open-flight/open-fp/hardware/cad/README.txt

open-fp - print files
Per plate: 4x 01_corner_cradle, 4x 02_cradle_retainer, 2x 07_edge_ramp_left, 2x 07_edge_ramp_right, 2x 07_edge_ramp_inner, 4x 10_hub_foot_tpu (TPU 95A)
Once: 1x 03_centre_enclosure_base, 1x 04_centre_enclosure_lid, 1x 09_drill_template (flip the plate for the other two corners)
Material: PETG or ABS (cradles carry load - no PLA). Cradles: 5 walls, 40% gyroid. Everything else: 3 walls, 20%. Hub feet: TPU 95A, 100% infill.
Orientation: cradles pocket-UP (plate face on bed; no supports/bridges - see hardware/bom.md), retainers flat, ramps on their flat bottom face, enclosure open-side up, lid vents-up, drill template lips-up.
Inserts: cradle M4 x2 (top), M2 x4 (bottom). Enclosure M2.5 in the 4 lid posts + Uno Q bosses + ADC grid as needed.
08_assembly_two_plates.step = full assembly for reference. forceplate_parts.py / extras_parts.py / assembly.py = CadQuery source.
08_assembly_two_plates.step predates the 2026-09-26 enclosure/ramp changes (see docs/VERIFIED.md).
