open-flight/open-fp/hardware/cad/renders/centre-enclosure-adc-fit.png

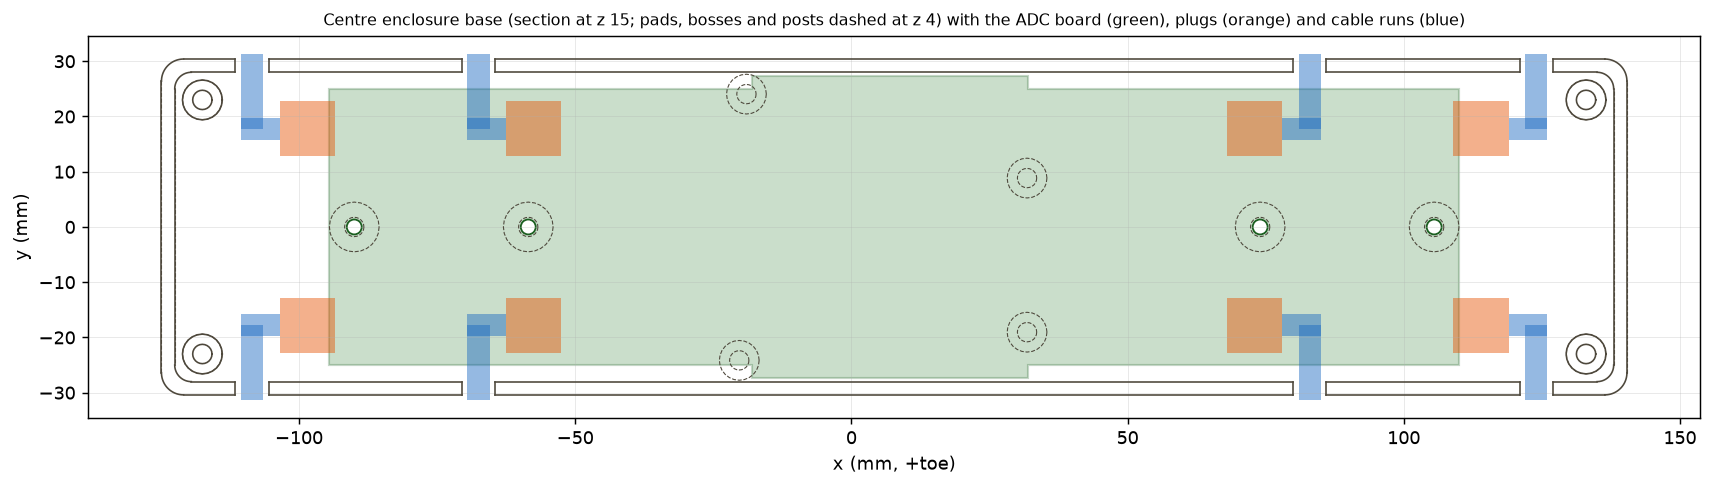
hardware/cad/renders/centre-enclosure-adc-fit.png
