open-flight/open-fp/hardware/pcb/adc-board/renders/adc-board-3d.png

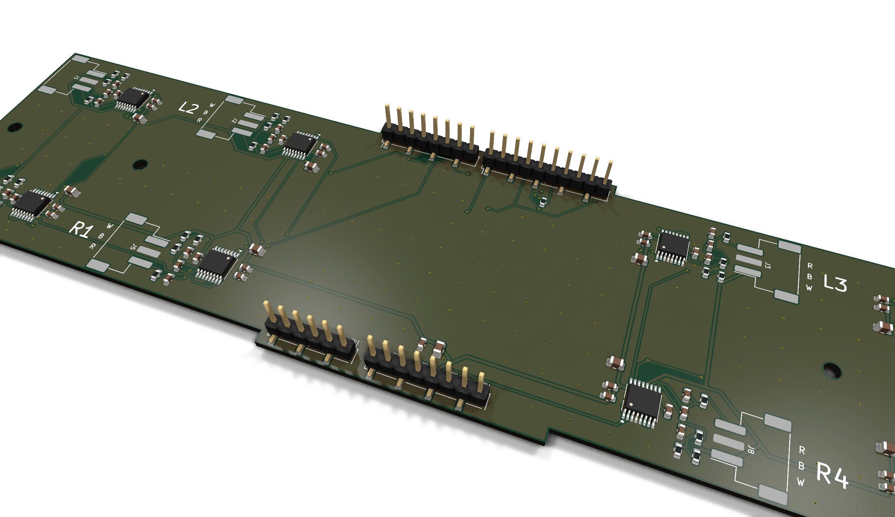
hardware/pcb/adc-board/renders/adc-board-3d.png
