open-flight/open-fp/hardware/pcb/adc-board/renders/adc-board-bottom.png

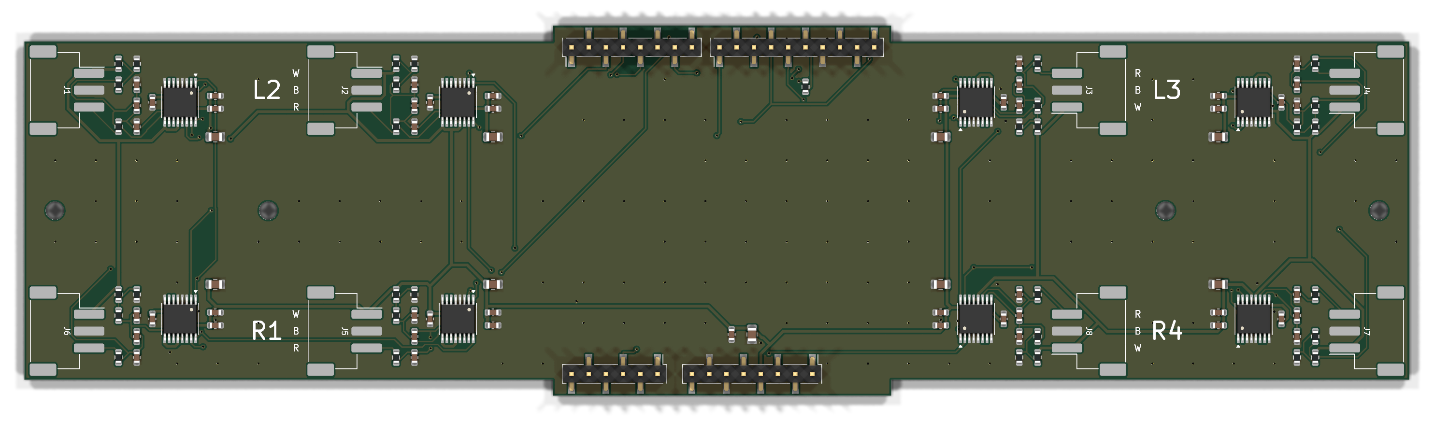
hardware/pcb/adc-board/renders/adc-board-bottom.png
