open-flight/open-fp/hardware/pcb/adc-board/renders/adc-board-top.png

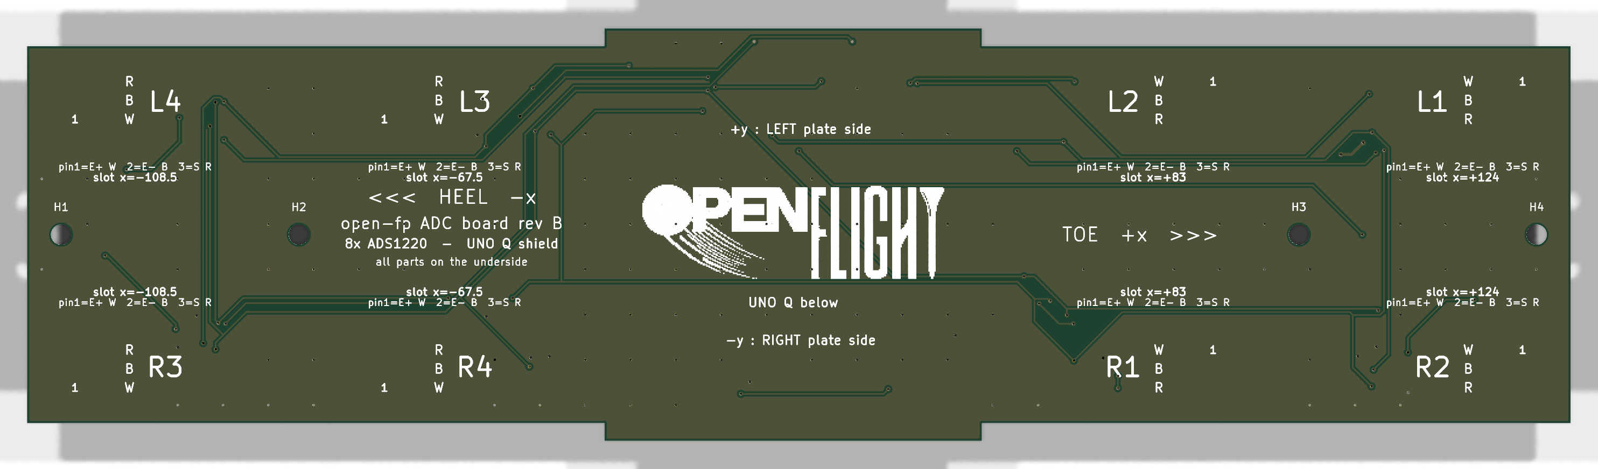
hardware/pcb/adc-board/renders/adc-board-top.png
