open-flight/open-fp/(list of files, cad)

Other CAD files:
hardware/cad/step/03_centre_enclosure_base.step
hardware/cad/stl/09_drill_template_b.stl
hardware/cad/step/04_centre_enclosure_lid.step
hardware/cad/stl/02_cradle_retainer.stl
hardware/cad/step/09_drill_template.step
hardware/cad/stl/09_drill_template_a.stl
hardware/cad/step/07_edge_ramp_inner.step
hardware/cad/step/07_edge_ramp_right.step
hardware/cad/step/11_cell_shim_tpu_1.5mm.step
hardware/cad/step/11_cell_shim_tpu_3.5mm.step
hardware/cad/step/11_cell_shim_tpu_3.0mm.step
hardware/cad/step/11_cell_shim_tpu_2.5mm.step
hardware/cad/step/10_hub_foot_tpu.step
hardware/cad/step/01_corner_cradle.step
hardware/cad/step/07_edge_ramp_left.step
hardware/cad/stl/01_corner_cradle.stl
hardware/cad/stl/03_centre_enclosure_base.stl
hardware/cad/stl/04_centre_enclosure_lid.stl
hardware/cad/stl/07_edge_ramp_left.stl
hardware/cad/stl/07_edge_ramp_right.stl
hardware/cad/stl/09_drill_template.stl
hardware/cad/stl/11_cell_shim_tpu_1.5mm.stl
hardware/cad/stl/11_cell_shim_tpu_2.5mm.stl
hardware/cad/stl/11_cell_shim_tpu_3.5mm.stl
