open-flight/open-fp/docs/VERIFIED.md

# VERIFIED

This file records the answer to every **VERIFY** item in [`PROJECT_INIT.md`](PROJECT_INIT.md). For each answer, give the tool, library, or datasheet version it was checked against and the date.

| # | Item | Answer | Checked against | Date |
|---|---|---|---|---|
| 1 | Arduino_RouterBridge: binary arg support in `notify()`, blocking behavior, max message size | | | |
| 2 | Router baud default (`arduino-router.service`); can it be raised on both sides? | **115200** on `/dev/ttyHS1`, set via `--serial-baudrate` in `/run/systemd/generator/arduino-router.service.d/10-imola.conf`. Whether it can be raised is still open. | `systemctl cat arduino-router` | 2026-09-23 |
| 3 | Zephyr core: `attachInterrupt` on D2, SPI on D11–D13 at 2 MHz, `micros()` resolution | D11/D12/D13 = PB15/PB14/PB13 = SPI2 MOSI/MISO/SCK (default `SPI`). D2 = PB3, `attachInterrupt` implemented (`WInterrupts.cpp`). **D10 = PB9 is in SPI2's pinctrl as hardware NSS**, so R4's CS moved to A2 (PA6, which only the ADC claims and has no pinctrl). Avoid A0 (DAC1 claims PA4), A1 (DAC out2), D0/D1 (USART1 console), A4/A5 (I2C3). D4/D5 are FDCAN1 pins, but CAN is deferred-init, so they work as GPIO unless CAN is started. **Hardware, 2026-09-25:** SPI at 2 MHz works (ADS1220 register readback OK), and `attachInterrupt` on D2 (FALLING) counts DRDY at ~950 Hz. About 9 edges are lost in each 100 ms window containing a Monitor RPC, so the router RPC appears to block interrupts briefly. Still open: `micros()` resolution. | arduino:zephyr 1.0.0 variant overlay and generated devicetree | 2026-09-23 |
| 4 | WebUI brick: Socket.IO event naming, `expose_api` path params + POST bodies, bind address, static asset path | Binds `0.0.0.0:7000`; assets from `/app/assets` (needs `index.html`). `expose_api(method, path, fn)` = FastAPI `add_api_route`, so path params and body models work the standard FastAPI way; `ui.app` is the FastAPI instance. `send_message(event, dict\|str, room=None)` → `sio.emit(event, …)`; browser uses `libs/arduino.js` `WebUI.on_message(event, cb)` on raw socket.io. Server started only when `WebUI()` is instantiated in `main.py`. | `python-apps-base:0.12.0`, `arduino/app_bricks/web_ui/web_ui.py` | 2026-09-23 |
| 5 | App container: persistent data path, `requirements.txt` support, numpy preinstalled? | numpy 2.5.1, fastapi 0.141.1, uvicorn 0.52.1, msgpack 1.2.1 preinstalled (CPython 3.13.14). App venv lives in `<app>/.cache/.venv`. Persistence and `requirements.txt` handling are still open. | `docker run python-apps-base:0.12.0` | 2026-09-23 |
| 6 | `arduino-app-cli`: start/stop/logs/autostart commands; App Lab app dir on the board | App dir `/home/arduino/ArduinoApps/open-fp`. `app start\|stop\|restart <path>`, `app logs <path> [--follow] [--tail N] [--all]`, `monitor` (MCU serial). Autostart candidate: `properties set default <path>` (boot behavior untested). **No `rsync` on board**: deploy uses tar. | `arduino-app-cli` 0.13.0 | 2026-09-23 |
| 7 | ADS1220 module: exposed pins (CLK, REFP0/REFN0, AVDD/DVDD), onboard regulator, hole spacing | Purple ADS1220 breakout. Left edge: DRDY, MISO, MOSI, SCLK, CS, CLK, DVDD, DGND. Right edge: AIN0–AIN3, REFN0, REFP0, AVDD, AGND. Supplies and grounds are split (DVDD/AVDD, DGND/AGND), so both pairs must be wired; CLK is broken out, so tie it to GND. **Still open:** onboard regulator, board size and hole spacing. | owner's photo of the board | 2026-09-25 |
| 8 | Load cell wire colors (per cell, see `wiring.md`) | **Red = centre tap (S); white and black = ends (E+/E−)** on L1. Wiring white as S put AIN0 at the 3.3 V rail; with red on AIN0 it reads 1663 mV. Check the other seven with a meter. | ADC self-check on L1 | 2026-09-25 |
| 9 | App Lab first-boot steps (§11.1) | Board name, Wi-Fi, `arduino` password, updates, exactly as in §11.1. Board reachable at `open-fp.local`. OS: Debian 13 (trixie), kernel 6.16.7, aarch64. | App Lab (owner), `uname -a` | 2026-09-23 |

## Bench measurements (M1/M2)

| Channel | Unloaded mean (counts) | Std dev (counts) | Register readback | Notes |
|---|---|---|---|---|
| L1 | 172,789 (differential) | 606 | OK (`81 C4 40 00`) | AIN0 1660 / AIN1 1660 mV; 13 % repeated reads (bench loop). Earlier: single-ended 4,204,513, std 116, thumb press −343 (2026-09-25). toe carrier on stripboard, differential gain 128 with 1.5 kΩ R1/R2; press test pending. 2026-10-12 |
| L2 | 1,405,031 (differential) | 1,076 | OK (`81 C4 40 00`) | AIN0 1659 / AIN1 1655 mV. toe carrier on stripboard, differential gain 128 with 1.5 kΩ R1/R2; press test pending. 2026-10-12 |
| L3 | | | | |
| L4 | | | | |
| R1 | −2,509,256 (differential) | 2,018 | OK (`81 C4 40 00`) | AIN0 1661 / AIN1 1669 mV: the R1/R2 pair is about 8 mV off centre, so about 30 % of the range goes to offset. toe carrier on stripboard, differential gain 128 with 1.5 kΩ R1/R2; press test pending. 2026-10-12 |
| R2 | 198,719 (differential) | 814 | OK (`81 C4 40 00`) | AIN0 1660 / AIN1 1660 mV. toe carrier on stripboard, differential gain 128 with 1.5 kΩ R1/R2; press test pending. 2026-10-12 |
| R3 | | | | |
| R4 | | | | |

Achieved loop rate: L1 DRDY 944 Hz; the bench sketch reads about 71 % of conversions with four channels (Monitor output blocks it) · `drdyMissed` over 10 min: —

## Toolchain

| Item | Answer | Checked against | Date |
|---|---|---|---|
| FQBN for `arduino-cli` | `arduino:zephyr:unoq` (core `arduino:zephyr`, "Arduino Q Boards") | arduino-cli 1.5.1, arduino:zephyr 1.0.0, `arduino-cli board list` | 2026-09-23 |
| Board ports | USB serial `/dev/cu.usbmodem*` and network port (mDNS `open-fp.local`), both detected as Arduino UNO Q | `arduino-cli board list` | 2026-09-23 |
| Compiling on this Mac | Arduino's builtin `ctags` 5.8-arduino11 is x86-only and fails (`bad CPU type`) without Rosetta. `tools/bench/flash.sh` swaps in a no-op stand-in when it can't run; ctags only generates function prototypes, and the bench sketches define every function before use. `bench/ads1220_all` compiles: 95 KB flash, 42 KB RAM | arduino-cli, arduino:zephyr 1.0.0, macOS (Darwin 27) on Apple Silicon | 2026-09-29 |

## Bench tooling

| Item | Answer | Checked against | Date |
|---|---|---|---|
| `Monitor` for bench sketches | `Arduino_RouterBridge` 0.4.3 `Monitor` (a `Stream`) sends output to the Linux side as `mon/write` RPCs; read it with `arduino-app-cli monitor` | library source `src/monitor.h` | 2026-09-24 |
| `bench/ads1220_single` builds | compiles for `arduino:zephyr:unoq` (89 KB flash, 36 KB RAM) | arduino-cli 1.5.1, arduino:zephyr 1.0.0, Arduino_RouterBridge 0.4.3 | 2026-09-24 |
| USB upload + monitor | **Works end to end.** `tools/bench/flash.sh` uploads over USB: arduino-cli → adb → OpenOCD on the Linux side, which flashes the STM32U585 (2 MB, dual-bank, RDP 0). `ssh arduino@open-fp.local arduino-app-cli monitor` streams the sketch's `Monitor` output, including without a TTY (what `single_cell.py` uses), and keystrokes sent to it reach the sketch (`r` re-runs the readback). With no ADC wired: `R,0,00,00,00,00` (D12 floats low), then `E,no DRDY` every 500 ms. | arduino-cli 1.5.1, UNO Q over USB | 2026-09-24 |

## Bench findings

| Item | Result | Checked against | Date |
|---|---|---|---|
| Monitor RPC cost | Each `Monitor.available()`/`println` call blocks the MCU loop for roughly 13 ms (a loop polling DRDY captured ~150 of 1000 samples/s when checking `Monitor.available()` every loop). **The firmware must not call the router in the sampling loop;** batch sends as the spec plans (`Bridge.notify` at 20 Hz) and check whether they block the same way. | bench/ads1220_single on hardware | 2026-09-25 |
| ADC self-test ('v') on L1, wired except R1/R2 | AVDD 3333 mV, external REF 3316 mV (REFP0/REFN0 OK), AIN1 552 mV (floating, no R1/R2 yet), **AIN0 > 2048 mV: at the 3.3 V rail, not the ~1650 mV centre-tap voltage.** Cause: white was wired as S, but red is the centre tap. **After swapping (red → AIN0):** AVDD 3333, REF 3317, **AIN0 1663 mV**. Single-ended reading ≈ 4,204,500 counts (= 1663/3317 of full scale), per-sample noise 127 counts at gain 1, 100 ms means within ~60 counts, DRDY 94–95 per 100 ms. | bench/ads1220_single voltage check | 2026-09-25 |

- **2026-09-25, L1 live view (single-ended, gain 1):** 100 ms averages steady within tens of counts, rate ~940 Hz. **Occasional single-sample outliers of −1,000 to −2,000 counts (one +800),** about 0.4–0.8 mV, visible only in the per-window min/max. Unconfirmed guess: a late read when a Monitor RPC delays the loop, racing the next conversion. Recheck in differential mode with R1/R2, and in the real firmware, which reads each sample paced by DRDY.

| Enclosure interior, measured from `03_centre_enclosure_base.step` | Outer 294.8 × 60.8 × 19.9 mm. Cavity about **55.8 mm wide**, 292 mm long, floor at z 2.6. **ADC pads** at each end: x ±47 to ±137 mm from centre, y ±25 (about **90 × 50 mm**), top at z 5.4, with a 7.5 mm grid of insert holes. **14.5 mm clearance** from the pad top to the rim. Lid posts at x = ±140, y ±23 (the x = 0 pair was removed 2026-09-26, see Mechanical fixes); UNO Q bosses near x ≈ 30. The ADS1220 breakout measures about 21 × 21 mm, with header columns 7 holes (17.8 mm) apart. **Carrier: 37 × 17-hole stripboard (~94 × 43 mm) with 4 breakouts in a row**, placed about x = 40–134 mm, clear of the UNO Q (|x| ≤ 34.3) and the lid posts (x ±140). Breakouts are soldered directly, with no sockets (sockets add ~8.5 mm). An earlier 2 × 2 idea was dropped: the paired pin rows make a single row fit. | CadQuery 2.8 probes of the STEP | 2026-09-25 |

- **2026-09-25, second breakout (bench, single-ended):** readback OK and voltages correct (AIN0 1655 mV), but **conversions are bit-identical** (raw dump: 32 × `3FFD8A`), with occasional jumps of exactly ±257 (0x101). The first breakout showed ~110 counts of noise in the same mode. Suspects: another board sharing the bus with its CS not held high, or a faulty or non-genuine chip. Swap test pending.

- **2026-10-16, carrier split is one per plate.** The first carrier holds all four corners of one plate, not the toe corners of both plates as `docs/harness.md` first described. The L1/L2/R1/R2 names in the table above are the CS slots each unit was on at the time (D3, D4, D7, D8), not its corner. Before the plates are used, re-wire the CS lines by corner (plate L carrier on D3–D6, plate R on D7, D8, D9, A2) and confirm each with a press test. Docs and diagrams updated to match.

## Performance

| Item | Result | Checked against | Date |
|---|---|---|---|
| Pipeline and SwingDetector CPU cost on the board | 41.9 s of synthetic 200 Hz data (5 swings, all captured) processed in 6.35 s, about 15 % of one core | `python-apps-base:0.12.0` on the UNO Q (Python 3.13.14, numpy 2.5.1) | 2026-09-23 |

## Mechanical fixes

- **2026-09-23, cable notch didn't break through.** The test print showed a wall in the cradle's cable notch. Measured from the STL: the notch spanned y −28…−18 and the pocket wall is at y −17.3, leaving a 0.7 mm wall through the notch's full 7.2 mm depth. The retainer's notch (y −28…−18) also stopped 4 mm short of its window (y −14), so it would clamp the wires against the cell. The owner confirmed the wall shouldn't be there. Fixed by loading the STEP files in CadQuery 2.8 and cutting 7 mm wide slots to join each notch to the pocket or window. Removed 35.3 mm³ (cradle) and 44.8 mm³ (retainer), both still single valid solids. STL and STEP re-exported.

- **2026-09-23, locating hub foot.** The owner asked for a foot that locates on the cell. The cell's load point is a riveted strap across the centre tongue with a dome in the middle, and it faces the floor. The new `10_hub_foot_tpu` (from `hardware/cad/src/hub_foot.py`) is Ø18 × 4.7 mm with an 11.4 × 1.2 mm channel for the strap and a Ø6 × 0.6 mm dimple for the dome. It keeps 3.5 mm of foot below the load point, so floor clearance is unchanged. The strap width (11.0) and dome diameter (5.5) were estimated from photos. **The test print fits well (owner, 2026-09-23)**, so the estimated dimensions stand.

- **2026-09-23, cell rattles vertically under the retainer.** The raised centre strap faces out, so the frame's outer edge sits a few mm below the rim and the flat retainer doesn't touch it. Added a TPU shim ring (`11_cell_shim_tpu`, from `hardware/cad/src/cell_shim.py`): 34 mm outside, 28.6 mm inside, so it rests only on the frame and stays clear of the tongue and strap, with a 9 mm gap at the cable notch. It comes as a tuning set of 1.5–3.5 mm; The fit test found the tightest stack was **3.5 mm under the cell plus 1.5 mm over it**, so the frame is about 3.2 mm thick. The 3.5 mm moved into the cradle as a rigid PETG ledge, keeping TPU out of the load path, and **the 1.5 mm TPU shim goes on top**.

- **2026-09-23, relief too small for the cell's tongue.** The Ø24 relief didn't clear the tongue, which is about 21 × 19 mm with a ~28 mm diagonal (estimated from a photo, frame = 34 mm). Anything touching the tongue carries load around the strain gauges and the reading comes out low. Replaced it with a 28 × 28 mm rounded-square relief (r 3), same 1.5 mm depth: 485.8 mm³ removed, still a single valid solid. The frame now bears on a 3 mm band all round, directly opposite the shim ring and retainer lip. **Confirmed by the owner:** the tongue does reach the old Ø24 cradle, so that print is retired and all 8 cradles are being printed from the new file.

- **2026-09-23, cradle bearing ledge.** Added a 3.5 mm PETG ledge to the pocket, between the 28 mm relief and the 34.6 mm pocket wall, so the frame bears at 4.7 mm from the open face: 1457 mm³ added, still a single valid solid, and the notch was re-cut clear. The tongue now has 5 mm of clearance to the relief ceiling. **Measured 2026-09-26 (owner):** a finished corner stands about 3/4" (19 mm) from floor to the cradle's plate face, so the aluminium top is at about 25.4 mm and the neoprene at about 27 mm. The ramps were raised to match (below).

- **2026-09-26, pre-print check of the remaining parts.** Checked in CadQuery 2.8 against the printed cradle stack. The drill template matches the cradle's M4 inserts (±22.5 mm) and centre, so it prints unchanged. (2026-09-28: template B, the mirror of A, was dropped and A renamed `09_drill_template`; flipping the plate covers the other two corners.) Changed:
  - **Enclosure base: centre lid posts removed.** The Q's bosses put its board at x −34.3…34.3, y −26.6…26.7 (UNO hole pattern), and the full-height posts at x = 0, y ±23 (Ø7.2) stood inside it, under the header rows. Removed 1329 mm³. The lid is now held by the four end posts; **install 4 lid inserts, not 6.**
  - **Enclosure base: cable slots added to the −y wall.** All four 6 × 6.7 mm slots (x ±85, ±125) were in the +y wall, which faces Plate L, so Plate R's cells had no way in. Mirrored them onto the −y wall (403 mm³ removed).
  - **Enclosure base: UNO Q bosses raised 3 → 5 mm** (top at z 7.4, owner's call for underside clearance), with the M2.5 insert holes now 5 mm deep to match the spec. 249 mm³ added. The Q's board top is now at z 9.0, so 8.5 mm female headers reach z 17.5, leaving **about 2.4 mm to the lid** (z 19.9) for wires entering the headers.
  - **Lid:** filled the two centre countersunk holes and their lip notches (61 mm³ added).
  - **Ramps: rise 20 → 24.5 mm,** about 1 mm below the aluminium top at the measured 25.4 mm, keeping the 60 mm run (slope 22°).
  - **Ramps: new `07_edge_ramp_inner`.** Every piece had a 45° mitre at one end, so on each plate's front and back sides the mitre pointed into the gap at the enclosure end, and the two plates' pieces overlapped by about 59 mm. The inner piece has square ends and stops 5 mm short of the gap centre, leaving a 10 mm channel. Now 4 left + 4 right + 4 inner (was 6 + 6).
  - All still single valid solids; STLs watertight. `08_assembly_two_plates.step` was not regenerated.
  - **Still open:** the USB-C slot is in the heel end wall, about 110 mm from the Q's USB-C port (board edge at x −34.3), so the cable has to run inside past the heel carrier.

- **2026-10-12, enclosure raised for the assembled ADC board** (`hardware/pcb/adc-board`, which sits on the Q's headers with its top at z 21.6). Edited in CadQuery 2.8 from the committed STEP files; both are still single valid solids.
  - **Base: walls and lid posts raised 2.4 mm** (wall top z 19.9 → 22.3, outer height 21.9 → 24.3 with the lid, still below the 24.5 mm ramps). Done by splitting at z 17 and inserting a 2.4 mm copy of the wall section, so the lid-post insert holes stay at the top (now 7.9 mm deep). 4325 mm³ added.
  - **Base: the eight cable slots now run z 2.4 → 19.0** (were 2.4 → 9.4), same 6 mm width at x ±85, ±125 in both long walls, so a cable leaves its JST plug (just under the board) straight through the wall. 1106 mm³ removed.
  - **Lid: locating lip removed on both long sides for x −34 … +34** (y 24.5 … 29), clearing the board's header tabs (y ±27.35 at x −18 … +32). Cut symmetric in x so the lid can go on either way round. 490 mm³ removed.
  - The stripboard carriers fit the taller enclosure unchanged. `08_assembly_two_plates.step` was not regenerated.

- **2026-11-11, enclosure rev B for the 204.5 mm ADC board** (`hardware/pcb/adc-board` rev B). The enclosure is now generated from source, `hardware/cad/src/centre_enclosure.py`, instead of edited in the STEP. Its `REV_A` parameters reproduce the committed rev A base and lid exactly (CadQuery 2.8 boolean difference against commit 064a41c: 0.00 mm³ both ways, both parts), so every rev A detail carries over, including the −y slots' 2.4 mm nick into the old pads. `REV_B` changes (details in the board README, "Rev B enclosure changes"):
  - **Cable slots** at x −108.5, −67.5, +83, +124 in both long walls (6 mm, z 2.4 – 19.0).
  - **ADC pads:** the two 90 × 50 mm pads and their 7.5 mm insert grid are replaced by four Ø9 pads (top z 5.4) with one Ø3.5 × 2.5 mm M2.5 insert hole each, at (−90, 0), (−58.5, 0), (+74, 0), (+105.5, 0).
  - **Lid posts** at x −117.5 / +133, y ±23 (2 mm past the outer slots), **cavity x −122.5 … +138**: outside 265.3 × 60.8 × 24.3 mm with the lid (was 294.8 long), x −124.9 … +140.4, so the box is no longer centred on x = 0. Shorter only makes the gap between the plates' ends and the box wider.
  - Lid: posts, countersunk holes and lip follow; vents keep the 12 mm grid (x −96 … +108).
  - Base 71 315 mm³ (was 100 908), lid 31 656 mm³ (was 35 096); both single valid solids.
  - **Fit check** (`hardware/cad/src/check_adc_fit.py`, reads `adc-board.kicad_pcb`): all four board holes on pad inserts (to 0.01 mm), and 0.00 mm³ overlap between the base or the fitted lid and the board, the underside-part zone, the UNO Q stack, the standoffs, the eight plugs and the cable runs to the slots. The same check on rev A fails (holes off the grid, six of eight cable runs into the wall). Plug size (10 × 10 mm) and the cable route are still estimates (**VERIFY** with a real plug). Not printed yet.
  - The stripboard carriers need rev A (`centre_enclosure.py --rev a`). `08_assembly_two_plates.step` was not regenerated.

## Notes found during scaffolding

- App Lab's generated skeleton puts the web client libs in `app/assets/libs/` (`arduino.js`, `socket.io.min.js`), not `assets/vendor/` as §2 planned. Keep `libs/` from the brick and put uPlot in `vendor/`.

- **CAD sources are not runnable as committed.** The scripts in `hardware/cad/src/` write to hard-coded output paths (`/home/claude`, `/home/claude/extras`). `assembly.py` also imports `cairosvg`. `forceplate_parts.py` exports `03_enclosure_base` and `04_enclosure_lid`, but the committed files are named `03_centre_enclosure_base` and `04_centre_enclosure_lid`. The sources are unchanged for now; ask the owner before editing them. (2026-11-11: the enclosure now has its own source, `centre_enclosure.py`, which writes to `hardware/cad` and supersedes the enclosure section of `forceplate_parts.py`.)
- **The CAD sources are an older revision than the STL/STEP files.** `forceplate_parts.py` has a cradle height of 14 mm (STL: 11.2), a relief depth of 2 mm (STL: 1.5), and a 2 mm retainer (STL: 1.6). Its enclosure is 150 × 70 mm, while the spec says 295 × 61 × 22. The STL/STEP files match the spec and are what gets printed. Update the sources before regenerating any part. Measured 2026-09-23 from the STL: the cradle is 54 × 54 × 11.2 with the pocket open at z=0, the pocket ceiling at 8.2, the relief ceiling at 9.7, the notch ceiling at 7.2, M2 holes 4 deep, and M4 holes 6.5 deep from the top.
