open-flight/open-fp/hardware/pcb/adc-board/adc-board.kicad_pcb

## KiCad design hardware/pcb/adc-board/adc-board.kicad_pcb (2026-11-11)

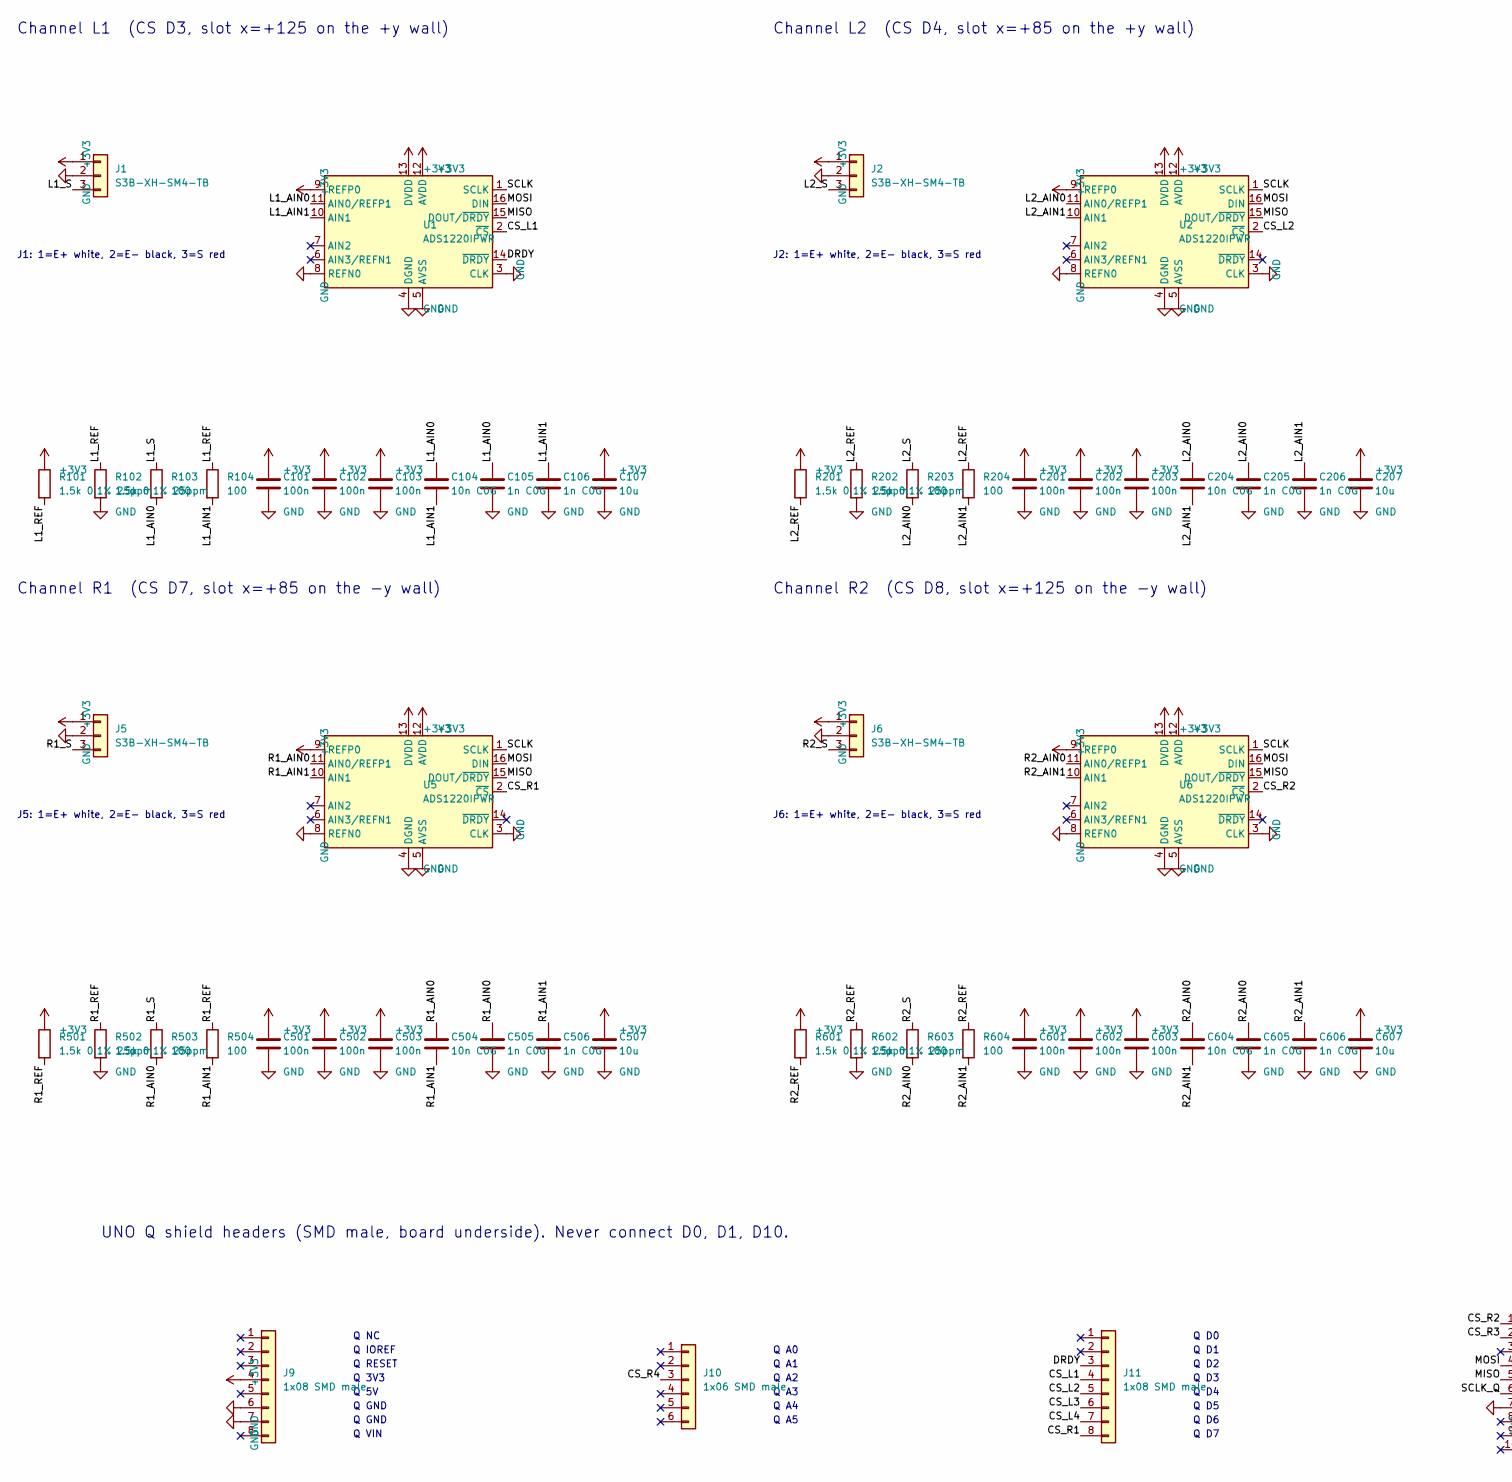
[picture p5: schematic adc-board.kicad_sch, open-fp ADC board (8x ADS1220, UNO Q shield), part in row 1, column 1]

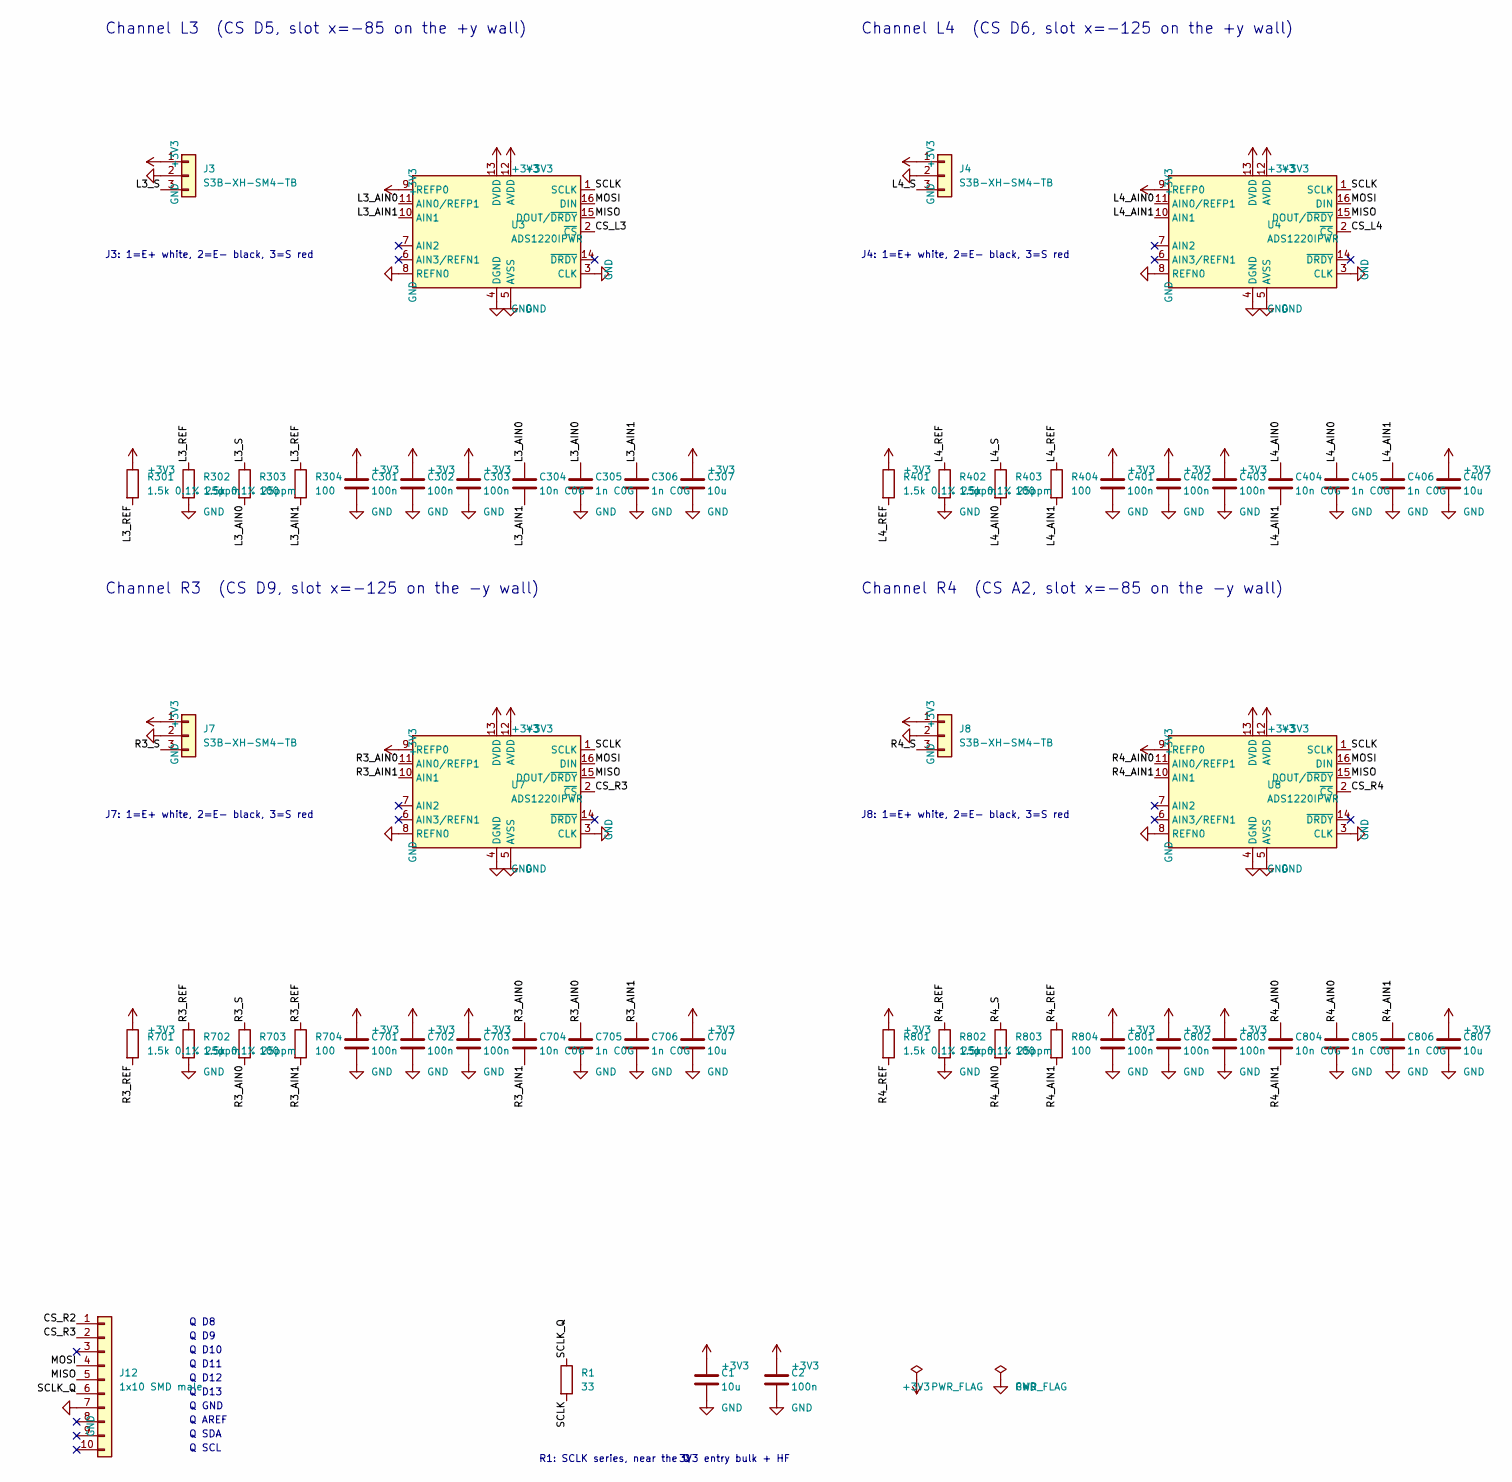
[picture p6: schematic adc-board.kicad_sch, open-fp ADC board (8x ADS1220, UNO Q shield), part in row 1, column 2]

Parts:
C1, C107, C207, C307, C407, C507, C607, C707, C807: 10u; C_0805_2012Metric; MPN GRM21BR61C106KE15L
C2, C101, C102, C103, C201, C202, C203, C301, C302, C303, C401, C402, C403, C501, C502, C503, C601, C602, C603, C701, C702, C703, C801, C802, C803: 100n; C_0603_1608Metric; MPN GRM188R71H104KA93D
C104, C204, C304, C404, C504, C604, C704, C804: 10n C0G; C_0603_1608Metric; MPN GRM1885C1H103JA01D
C105, C106, C205, C206, C305, C306, C405, C406, C505, C506, C605, C606, C705, C706, C805, C806: 1n C0G; C_0603_1608Metric; MPN GRM1885C1H102JA01D
J1, J2, J3, J4, J5, J6, J7, J8: S3B-XH-SM4-TB; JST_XH_S3B-XH-SM4-TB_1x03-1MP_P2.50mm_Horizontal; MPN S3B-XH-SM4-TB(LF)(SN)
J9, J11: 1x08 SMD male; PinHeader_1x08_P2.54mm_Vertical_SMD_Pin1Left; MPN TSM-108-01-T-SV-P
J10: 1x06 SMD male; PinHeader_1x06_P2.54mm_Vertical_SMD_Pin1Left; MPN TSM-106-01-T-SV-P
J12: 1x10 SMD male; PinHeader_1x10_P2.54mm_Vertical_SMD_Pin1Left; MPN TSM-110-01-T-SV-P
R1: 33; R_0603_1608Metric; MPN RC0603FR-0733RL
R101, R102, R201, R202, R301, R302, R401, R402, R501, R502, R601, R602, R701, R702, R801, R802: 1.5k 0.1% 25ppm; R_0603_1608Metric; MPN RG1608P-152-B-T5
R103, R104, R203, R204, R303, R304, R403, R404, R503, R504, R603, R604, R703, R704, R803, R804: 100; R_0603_1608Metric; MPN RC0603FR-07100RL
U1, U2, U3, U4, U5, U6, U7, U8: ADS1220IPWR; TSSOP-16_4.4x5mm_P0.65mm; MPN ADS1220IPWR

Connections:
+3V3: C1.1, C2.1, C101.1, C102.1, C103.1, C107.1, C201.1, C202.1, C203.1, C207.1, C301.1, C302.1, C303.1, C307.1, C401.1, C402.1, C403.1, C407.1, C501.1, C502.1, C503.1, C507.1, C601.1, C602.1, C603.1, C607.1, C701.1, C702.1, C703.1, C707.1, C801.1, C802.1, C803.1, C807.1, J1.1, J2.1, J3.1, J4.1, J5.1, J6.1, J7.1, J8.1, J9.4, R101.1, R201.1, R301.1, R401.1, R501.1, R601.1, R701.1, R801.1, U1.9 (REFP0), U1.12 (AVDD), U1.13 (DVDD), U2.9 (REFP0), U2.12 (AVDD), U2.13 (DVDD), U3.9 (REFP0), U3.12 (AVDD), U3.13 (DVDD), U4.9 (REFP0), U4.12 (AVDD), U4.13 (DVDD), U5.9 (REFP0), U5.12 (AVDD), U5.13 (DVDD), U6.9 (REFP0), U6.12 (AVDD), U6.13 (DVDD), U7.9 (REFP0), U7.12 (AVDD), U7.13 (DVDD), U8.9 (REFP0), U8.12 (AVDD), U8.13 (DVDD)
/CS_L1: J11.4, U1.2 (~CS)
/CS_L2: J11.5, U2.2 (~CS)
/CS_L3: J11.6, U3.2 (~CS)
/CS_L4: J11.7, U4.2 (~CS)
/CS_R1: J11.8, U5.2 (~CS)
/CS_R2: J12.1, U6.2 (~CS)
/CS_R3: J12.2, U7.2 (~CS)
/CS_R4: J10.3, U8.2 (~CS)
/DRDY: J11.3, U1.14 (~DRDY)
/L1_AIN0: C104.1, C105.1, R103.2, U1.11 (AIN0/REFP1)
/L1_AIN1: C104.2, C106.1, R104.2, U1.10 (AIN1)
/L1_REF: R101.2, R102.1, R104.1
/L1_S: J1.3, R103.1
/L2_AIN0: C204.1, C205.1, R203.2, U2.11 (AIN0/REFP1)
/L2_AIN1: C204.2, C206.1, R204.2, U2.10 (AIN1)
/L2_REF: R201.2, R202.1, R204.1
/L2_S: J2.3, R203.1
/L3_AIN0: C304.1, C305.1, R303.2, U3.11 (AIN0/REFP1)
/L3_AIN1: C304.2, C306.1, R304.2, U3.10 (AIN1)
/L3_REF: R301.2, R302.1, R304.1
/L3_S: J3.3, R303.1
/L4_AIN0: C404.1, C405.1, R403.2, U4.11 (AIN0/REFP1)
/L4_AIN1: C404.2, C406.1, R404.2, U4.10 (AIN1)
/L4_REF: R401.2, R402.1, R404.1
/L4_S: J4.3, R403.1
/MISO: J12.5, U1.15 (DOUT/~DRDY), U2.15 (DOUT/~DRDY), U3.15 (DOUT/~DRDY), U4.15 (DOUT/~DRDY), U5.15 (DOUT/~DRDY), U6.15 (DOUT/~DRDY), U7.15 (DOUT/~DRDY), U8.15 (DOUT/~DRDY)
/MOSI: J12.4, U1.16 (DIN), U2.16 (DIN), U3.16 (DIN), U4.16 (DIN), U5.16 (DIN), U6.16 (DIN), U7.16 (DIN), U8.16 (DIN)
/R1_AIN0: C504.1, C505.1, R503.2, U5.11 (AIN0/REFP1)
/R1_AIN1: C504.2, C506.1, R504.2, U5.10 (AIN1)
/R1_REF: R501.2, R502.1, R504.1
/R1_S: J5.3, R503.1
/R2_AIN0: C604.1, C605.1, R603.2, U6.11 (AIN0/REFP1)
/R2_AIN1: C604.2, C606.1, R604.2, U6.10 (AIN1)
/R2_REF: R601.2, R602.1, R604.1
/R2_S: J6.3, R603.1
/R3_AIN0: C704.1, C705.1, R703.2, U7.11 (AIN0/REFP1)
/R3_AIN1: C704.2, C706.1, R704.2, U7.10 (AIN1)
/R3_REF: R701.2, R702.1, R704.1
/R3_S: J7.3, R703.1
/R4_AIN0: C804.1, C805.1, R803.2, U8.11 (AIN0/REFP1)
/R4_AIN1: C804.2, C806.1, R804.2, U8.10 (AIN1)
/R4_REF: R801.2, R802.1, R804.1
/R4_S: J8.3, R803.1
/SCLK: R1.2, U1.1 (SCLK), U2.1 (SCLK), U3.1 (SCLK), U4.1 (SCLK), U5.1 (SCLK), U6.1 (SCLK), U7.1 (SCLK), U8.1 (SCLK)
/SCLK_Q: J12.6, R1.1
GND: C1.2, C2.2, C101.2, C102.2, C103.2, C105.2, C106.2, C107.2, C201.2, C202.2, C203.2, C205.2, C206.2, C207.2, C301.2, C302.2, C303.2, C305.2, C306.2, C307.2, C401.2, C402.2, C403.2, C405.2, C406.2, C407.2, C501.2, C502.2, C503.2, C505.2, C506.2, C507.2, C601.2, C602.2, C603.2, C605.2, C606.2, C607.2, C701.2, C702.2, C703.2, C705.2, C706.2, C707.2, C801.2, C802.2, C803.2, C805.2, C806.2, C807.2, J1.2, J2.2, J3.2, J4.2, J5.2, J6.2, J7.2, J8.2, J9.6, J9.7, J12.7, R102.2, R202.2, R302.2, R402.2, R502.2, R602.2, R702.2, R802.2, U1.3 (CLK), U1.4 (DGND), U1.5 (AVSS), U1.8 (REFN0), U2.3 (CLK), U2.4 (DGND), U2.5 (AVSS), U2.8 (REFN0), U3.3 (CLK), U3.4 (DGND), U3.5 (AVSS), U3.8 (REFN0), U4.3 (CLK), U4.4 (DGND), U4.5 (AVSS), U4.8 (REFN0), U5.3 (CLK), U5.4 (DGND), U5.5 (AVSS), U5.8 (REFN0), U6.3 (CLK), U6.4 (DGND), U6.5 (AVSS), U6.8 (REFN0), U7.3 (CLK), U7.4 (DGND), U7.5 (AVSS), U7.8 (REFN0), U8.3 (CLK), U8.4 (DGND), U8.5 (AVSS), U8.8 (REFN0)

Notes on the sheet:
Channel L1 (CS D3, slot x=+125 on the +y wall)
J1: 1=E+ white, 2=E- black, 3=S red
Channel L2 (CS D4, slot x=+85 on the +y wall)
J2: 1=E+ white, 2=E- black, 3=S red
Channel L3 (CS D5, slot x=-85 on the +y wall)
J3: 1=E+ white, 2=E- black, 3=S red
Channel L4 (CS D6, slot x=-125 on the +y wall)
J4: 1=E+ white, 2=E- black, 3=S red
Channel R1 (CS D7, slot x=+85 on the -y wall)
J5: 1=E+ white, 2=E- black, 3=S red
Channel R2 (CS D8, slot x=+125 on the -y wall)
J6: 1=E+ white, 2=E- black, 3=S red
Channel R3 (CS D9, slot x=-125 on the -y wall)
J7: 1=E+ white, 2=E- black, 3=S red
Channel R4 (CS A2, slot x=-85 on the -y wall)
J8: 1=E+ white, 2=E- black, 3=S red
UNO Q shield headers (SMD male, board underside). Never connect D0, D1, D10.
Q NC
Q IOREF
Q RESET
Q 3V3
Q 5V
Q GND
Q VIN
Q A0
Q A1
Q A2
Q A3
Q A4
Q A5
Q D0
Q D1
Q D2
Q D3
Q D4
Q D5
Q D6
Q D7
Q D8
Q D9
Q D10
Q D11
Q D12
Q D13
Q AREF
Q SDA
Q SCL
R1: SCLK series, near the Q
3V3 entry bulk + HF

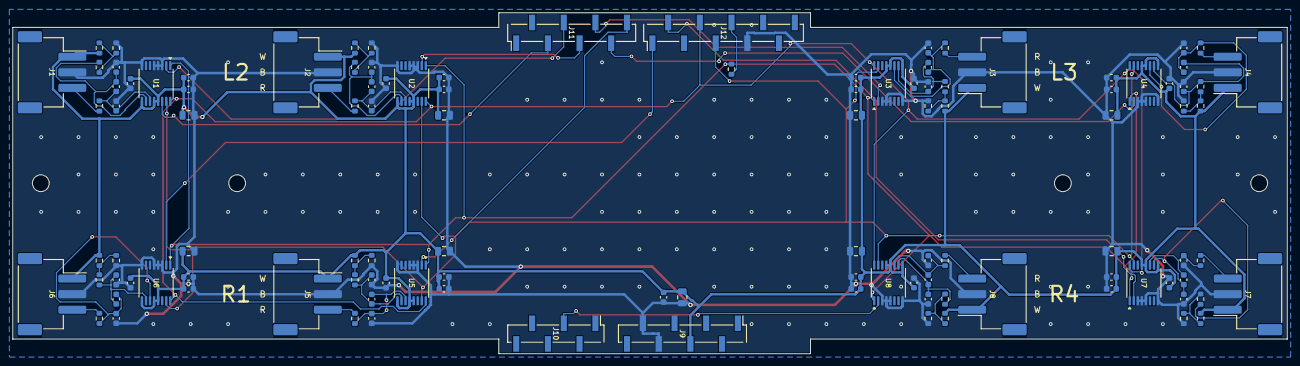
[picture p7: board adc-board.kicad_pcb from below]

Board: 2 copper layers, 204.5 x 54.7 mm, 115 parts (111 on the bottom side), 47 nets.

Other parts of the board:
H1, H2, H3, H4: M2.5; MountingHole_2.7mm_M2.5
