open-flight/open-fp/(commit log)

2026-09-23 M0: repo scaffold, CAD import, README, BOM, docs
    - Directory layout per docs/PROJECT_INIT.md §2
    - CAD sorted into hardware/cad/{stl,step,src}; STL/STEP tracked with Git LFS
    - README with system limitations, BOM, wiring/assembly/calibration docs,
    VERIFIED.md template, board_setup.sh and deploy.sh
2026-09-23 Rename project to open-fp
    Board hostname, App Lab app name, and deploy paths are now open-fp;
    the Python package is open_fp (hyphens aren't valid in module names).
2026-09-23 board_setup.sh: install SSH key without ssh-copy-id
    ssh-copy-id requires the private key on disk, which fails when the key
    lives in an agent such as 1Password. Append the public key directly and
    idempotently instead. Also record the verified arduino-cli FQBN.
2026-09-23 Import App Lab skeleton; document reproducible setup
    - app/app.yaml, sketch/, python/main.py, assets/ as generated by App Lab
    (WebUI - HTML brick) for app "open-fp"
    - deploy.sh: tar over ssh (board has no rsync), arduino-app-cli app restart
    - tools/logs.sh, tools/dev_setup.sh (git-lfs, arduino-cli + zephyr core, venv)
    - docs/SETUP.md: fresh clone + fresh board walkthrough and troubleshooting
    - VERIFIED.md: router baud, WebUI brick API, container packages, app CLI
2026-09-23 open_fp.calibration: least-squares gains, wizard session, persistence
2026-09-23 open_fp.store: swing persistence, CSV export; docs and deploy tweaks
    - store: <id>.json + <id>.npz, newest-first listing, strict id validation
    - deploy.sh: tar --no-xattrs (silences macOS xattr warnings on the board)
    - README status; VERIFIED: pipeline + detector CPU cost measured on board
2026-09-23 App core, HTTP API and simulator server
    - open_fp.app.Core: framework-free app logic shared by board and sim
    (payload handling, 30 Hz live / 1 Hz status, config, calibration
    wizard, manual record, shot events, swing library), one lock
    - open_fp.web.register: §9.8 routes on any expose_api() host, with
    404/400/409 error mapping and CSV download
    - tools/sim/sim_server.py: same FastAPI + fastapi_socketio wiring as the
    WebUI brick, streams synthetic sessions in real time with shot events
    - vendor uPlot 1.6.32
2026-09-24 Web UI: live view, swing replay, library, diagnostics
    - stance view: plates to scale, per-cell load rings, per-foot CoP sized
    by force, combined CoP with 3 s trail; lead always drawn on the left
    - balance readout, uPlot force trace (live 5 s / replay with event lines
    and cursor), metrics strip, swing library cards with mini CoP path
    - replay: phase-coloured CoP path, scrubber, 1/4-1/2-1x playback, event
    chips, CSV export, delete
    - diagnostics: link stats and per-channel counts/tare/spread/force
    - live message now carries per-cell forces; sim defaults to port 7070
    (macOS AirPlay Receiver holds 7000)
2026-09-24 Docs: print cradles pocket-up; note CAD source is older than STLs
    Pocket-up needs no supports or bridges and prints the load-bearing
    pocket seat as a solid top surface. The committed CadQuery source
    predates the STL/STEP revision (cradle 14 vs 11.2 mm, old enclosure).
2026-09-24 Wiring guide; move R4 chip select from D10 to A2
    docs/wiring.md is now a step-by-step build guide: cell identification,
    JST-XH terminations, cable runs, ADS1220 prep, bridge completion, bus
    harness, pre-power checklist and first power-up.
    D10 (PB9) is SPI2's hardware NSS in the UNO Q devicetree, so SPI.begin()
    would drive it low on every transfer and select R4 during other boards'
    reads. R4's CS moves to A2 (PA6), which no peripheral claims. Verified
    against the arduino:zephyr 1.0.0 variant; spec and VERIFIED.md updated.
2026-09-24 Fix cable notch in cradle and retainer; corner assembly diagram
    The cradle's cable notch stopped 0.7 mm short of the pocket and the
    retainer's notch stopped 4 mm short of its window, trapping and clamping
    the cell wires (found on the first test print). Cut both through from
    the STEP files with CadQuery; only the walls were removed.
    docs/img/corner-assembly.svg (generated by make_corner_diagram.py):
    exploded and assembled cutaways, bottom view for notch alignment, and
    plate plan showing notches facing the enclosure. Linked from assembly.md.
2026-09-24 Locating TPU hub foot for the cell's centre strap
    Parametric hardware/cad/src/hub_foot.py: Ø18 foot with a channel for the
    riveted centre strap and a dimple for the dome, so the foot self-centres.
    Keeps 3.5 mm below the load point. Strap width and dome diameter are
    photo estimates pending caliper measurements.
2026-09-24 TPU shim ring to stop the load cell rattling in the cradle
    The raised centre strap leaves the frame a few mm below the rim, so the
    retainer doesn't touch it. cell_shim.py makes a ring that presses only
    on the frame's outer edge (clear of tongue/strap, gap at the cable
    notch), as a 1.5-3.5 mm tuning set identified by edge nicks.
2026-09-24 VERIFIED: locating hub foot test print fits
2026-09-24 Cradle relief: 28 mm rounded square so only the frame ring bears
    The Ø24 relief didn't clear the corners of the cell's ~21 x 19 mm tongue;
    any contact there shunts load around the strain gauges. Enlarged to a
    28 x 28 mm rounded square at the same depth, leaving a 3 mm bearing band
    on the frame opposite the shim ring and retainer lip.
2026-09-24 Cradle: 3.5 mm PETG bearing ledge; 1.5 mm TPU shim on top
    The owner's fit test found 3.5 mm under the cell + 1.5 mm over it; the
    cell frame is ~3.2 mm (7.8 mm includes the raised strap). The 3.5 mm
    under the cell carries every corner's full load, so it is now rigid PETG
    in the cradle rather than TPU. The 1.5 mm TPU shim stays on top as a
    compliant retainer. Diagram redrawn with the real cell profile.
2026-09-24 ci: tests, lint, PR checks and anti-slop audit
    - tests.yml: pytest on Python 3.12 and 3.13 (the board runs 3.13)
    - lint.yml: ruff, pylint --fail-under=9, generated-diagram drift check,
    shellcheck for tools/*.sh
    - pr-checks.yml and anti-slop.yml adapted from open-flight/openflight,
    with the PR template they rely on
    - requirements-dev.txt pins dev/CI deps; dev_setup.sh installs from it
    - CODEOWNERS and Dependabot (pip, github-actions)
2026-09-24 feat(bench): one-cell ADS1220 bench test (M1)
    - bench/ads1220_single: configures one ADS1220 (L1: CS D3, DRDY D2),
    prints register readback and 100 ms stats (n, mean, std, min, max) of
    1000 SPS samples via Monitor; 'r' re-checks the ADC. Compiles for
    arduino:zephyr:unoq.
    - tools/bench/single_cell.py: guided test over `arduino-app-cli monitor`
    (readback, unloaded baseline, press test, optional counts/kg), with
    unit-tested analysis. tools/bench/flash.sh finds the UNO Q's USB port.
    - docs/bench-single-cell.md with a generated wiring diagram
    (docs/img/make_bench_wiring.py); linked from wiring.md and README.
    - CI: lint and PR checks cover tools/bench; the diagram drift check now
    run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
2026-09-24 bench: verified flash + monitor path on the board; clearer failures
    - single_cell.py stops after a failed register readback instead of
    running steps that can't pass, shows each sketch error once, and says
    "no data" rather than printing zeros
    - bench guide: an unconnected D12 reads back 00 00 00 00
    - VERIFIED: USB upload (adb -> OpenOCD) and `arduino-app-cli monitor`
    confirmed on hardware with no ADC wired
2026-09-24 docs: harness diagram and ADC carrier build for 8 cells
    docs/img/harness.svg (generated by make_harness_diagram.py): 14 UNO Q
    pins, one wire each, to two perfboard ADC carriers (toe L1 L2 R1 R2,
    heel L3 L4 R3 R4). The 5 shared bus lines chain Q -> toe -> heel; each
    ADC has its own CS; only L1's DRDY is wired. wiring.md §8 rewritten
    around the carriers, replacing the ASCII sketch.
2026-09-25 docs(bench): match the ADS1220 breakout's silkscreen and pin order
    The bench diagram used generic names (DIN/DOUT, one GND, AVDD/VCC). The
    breakout in this build labels MOSI/MISO, splits DVDD/AVDD and DGND/AGND,
    and breaks out CLK. Redrawn with its exact names in physical order, with
    UNO Q pins lined up so every wire is straight; table and troubleshooting
    updated; both grounds and both supplies called out. VERIFIED item 7 now
    records the pinout (regulator, size and holes still open).
2026-09-25 bench: single-ended mode, ADC voltage self-check, DRDY interrupt count
    - 's'/'d' switch between AIN0-GND gain 1 (usable before R1/R2 are
    fitted) and AIN0-AIN1 gain 128; single_cell.py --single-ended uses
    thresholds scaled for gain 1
    - 'v' measures AVDD, AIN0, AIN1 against the internal 2.048 V reference
    and the external reference, so wiring faults show up without a meter
    - DRDY counted by interrupt on D2 so the sample-rate check measures the
    ADC, not the loop; Monitor polled every 200 ms (each call is a ~13 ms
    RPC that was starving the loop)
    - VERIFIED: SPI + DRDY interrupt confirmed on hardware; Monitor RPC cost;
    first L1 self-check (AIN0 at the 3.3 V rail)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
2026-09-25 docs: L1 wire colours (red = S) and post-fix self-check results
2026-09-25 bench: drift-aware release check; save raw windows; record L1 run
    The first single-ended run passed readback and the press test (-343
    counts) but failed the release check: the tolerance was ~37 counts while
    the baseline drifted 176 counts in 10 s. The tolerance is now the largest
    of the mode floor, 25% of the press and 1.5x the baseline drift; the
    script prints where the reading settled and saves the raw 100 ms windows
    in the results JSON.
2026-09-25 bench: live browser view for the one-cell test
    tools/bench/live_view.py streams the bench sketch over SSH and serves a
    page at localhost:7071 (server-sent events, vendored uPlot, stdlib only):
    change since tare, 30 s chart of 100 ms means with min-max band, rate,
    noise, readback, voltage check, and buttons for the sketch's keys. Parser
    gains M (mode) and V (voltage) lines. Regression test for the page
    reading the right stats field names.
    VERIFIED: first live view shows rare single-sample outliers; cause open.
2026-09-25 bench: close the ssh monitor on SIGTERM
    Stopping live_view.py or single_cell.py with pkill left the child
    `ssh ... arduino-app-cli monitor` running, which holds the monitor. Both
    now exit through their normal cleanup on SIGTERM.
2026-09-25 docs: step-by-step system wiring guide (unit -> carrier -> chain)
    Replaces the single dense harness diagram with docs/harness.md and three
    generated diagrams (docs/img/make_harness_steps.py, shared helpers in
    docs/img/_svg.py):
    1. a unit: breakout + R1/R2 + JST, exposing 6 wires (DRDY on L1)
    2. four units on a carrier: 5 full-width bus rails with BUS IN / BUS
    OUT headers, CS and cell sockets along the bottom edge
    3. the system, laid out as it sits: Q -> toe carrier -> heel carrier
    bus chain, CS bundles, cell cables routed around inner corners
    Bundle and pin tables, pre-power checks, and one-unit-at-a-time bring-up.
    wiring.md §8 and README point to the new guide.
    Co-Authored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
2026-09-25 VERIFIED: enclosure interior and ADC pad dimensions (carriers ~90 x 50 mm)
2026-09-25 docs: ADC carrier stripboard layout (4 breakouts in a row, 94 x 43 mm)
    docs/img/carrier-stripboard.svg (generated by make_carrier_layout.py):
    37 x 17-hole stripboard. The breakout's paired pin rows (AGND|DGND,
    AVDD|DVDD) let strips A/B be GND/3V3 rails under all four breakouts;
    J/K/L carry SCLK/MOSI/MISO; N/O repeat 3V3/GND at the JSTs. Every cut,
    link, JST and external wire is placed. harness.md step 2 gains the cut
    list, link table and build order; VERIFIED records the breakout size
    and the carrier's fit in the enclosure.
2026-09-26 docs: R1/R2 need to be an equal, matched pair; value can be 680 Ω–2 kΩ
2026-09-26 bench: raw-dump diagnostic ('x'); viewer waits for mode changes to settle
    The second breakout returns bit-identical conversions (3FFD8A x32) with
    jumps of exactly 257, unlike the first breakout's normal noise. 'x' dumps
    32 raw conversions to diagnose this kind of fault; documented in the
    bench guide and troubleshooting. The live view no longer auto-tares on
    windows captured mid mode switch.
2026-09-28 Enclosure, ramps, drill template: fixes from the pre-print check
    - Base: remove the x=0 lid posts (they stood inside the UNO Q's outline);
    mirror the four cable slots onto the -y wall so Plate R's cells get in;
    raise the Q bosses 3 -> 5 mm with 5 mm insert holes.
    - Lid: fill the two centre screw holes and lip notches.
    - Ramps: rise 20 -> 24.5 mm for the measured 3/4" corner stack; new
    square-ended 07_edge_ramp_inner for the enclosure end (the mitred pieces
    from the two plates overlapped there). Now 4 left + 4 right + 4 inner.
    - Drill template: drop the mirrored B; flip the plate for the other two
    corners. A renamed to 09_drill_template.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
2026-09-28 Drill template: one full-edge strip with all four guide holes
    Replaces the corner template (and its flip-the-plate workaround): lay it
    along an enclosure-parallel edge, drill 4, turn it 180 for the opposite
    edge. 43 x 307.8 mm, fits the X2D bed rotated 45 deg.
2026-09-28 Drill template: back to the small corner template
    Reverts e0cbfd1 (full-edge strip). One corner template: drill two diagonally
    opposite corners from the top, flip the plate for the other two.
2026-09-28 BOM: BusBoard ST2 stripboard for the ADC carriers
2026-09-28 Harness: JST at the cradle; cell cables solder straight to the carrier
    Upright JST sockets on the carrier don't fit under the lid, and the plug
    can't pass the 6 x 6.7 mm wall slot. The carrier's JST positions become
    E+/E-/S solder pads (rows N/O/P); cable cores now match the cell's colours
    (white E+, black E-, red S). Adds the carrier height budget (~3 mm nylon
    standoffs) and fixes wiring.md's no-headers step, which the carrier needs.
2026-09-29 bench: all-channel sketch and guided multi-unit test for carrier bring-up
    bench/ads1220_all configures all 8 chip-selects, reads every board that
    answers on each L1 DRDY tick (1 ms timer if L1 is absent), and reports one
    stats line per 250 ms window plus per-board voltage checks and raw dumps.
    tools/bench/multi_cell.py walks through: who answers on which CS, per-unit
    voltages (and R1/R2 detection, which picks differential vs single-ended),
    an unloaded baseline that catches stuck/noisy/saturated units, and a press
    test per cell that names swapped cables or crossed CS wires.
    flash.sh: fall back to a no-op ctags when Arduino's x86 ctags can't run
    (Apple Silicon without Rosetta); fix empty-arr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
2026-09-30 Carrier as a DIY Layout Creator project; CS wire on top of the CS pin
    hardware/carrier-stripboard.diy is generated from the same layout data as
    the SVG (make_carrier_diylc.py imports make_carrier_layout's cuts, links and
    breakout positions). Field layout copied from DIYLC 4.34 sample projects;
    not opened in DIYLC here (no Java), XML checked and positions previewed.
    CS hole (x0+5, D) sat under the breakout once it's soldered on: the CS wire
    now goes on top of the CS pin, like L1's DRDY.
2026-09-30 Carrier DIYLC project: R1/R2 inset, strip-by-strip labels, clearer cable shield
    Adds a zoomed 'top of each breakout' inset with every pin named, R1
    (AVDD-AIN1) and R2 (AIN1-AGND), and the CS/DRDY wires soldered on top;
    a description beside every strip; UNO Q pin names on the bus wires; and
    notes that each cell has 3 wires while grey is the cable's shield.
    Loads cleanly in DIYLC 6.6.0.
2026-09-30 bench: guided pre-power meter check for a carrier (carrier_check.py)
    Walks through continuity and resistance checks by build stage (bare board,
    units fitted, cells plugged in, wired to the UNO Q), with expected values
    scaled to the number of units and a hint for every failure.
2026-10-11 Carrier layout adopts the first board's mirrored cuts; resistor value in the pre-power check; Smart2Move note
    The first carrier was cut from the copper side while reading the component-side
    drawing. Between-unit cuts are symmetric, so only the in-unit cut (x0+3 -> x0+4)
    and row P cuts (x0, x0+3 -> x0+4, x0+7) change; SCLK becomes an insulated
    diagonal (x0+6,E)->(x0+4,J). Connectivity checked net by net. harness.md now
    warns that the drawing is the component side.
    carrier_check.py --resistor sets R1/R2 (any matched pair 680 R-2 k).
    Adds docs/research/smart2move-comparison.md (public sources only).
2026-10-11 multi_cell: wait for the monitor to attach before sending the first key
    The first 'r' was sent before arduino-app-cli monitor was attached and got
    lost, so the script reported no readback at all. Seen on the first carrier.
2026-10-11 multi_cell: a reading pinned at full scale is saturation, not a stuck ADC
    Seen on the first carrier with no cell connected (AIN0 floating).
2026-10-13 hardware: assembled 8-channel ADC board (pcb/adc-board) for PCBWay
    UNO Q shield, 284 x 50 mm, 2 layers: 8 x ADS1220IPWR on board, 1.5k 0.1% bridge
    completion, input RC filter, JST-XH 3-pin per cell, all parts SMD on the underside
    (one-sided assembly). Generated from scripts/design.py; ERC/DRC clean. Gerbers,
    BOM, centroid, renders, schematic PDF. Firmware pin map unchanged.
2026-10-13 Enclosure: raise walls 2.4 mm, taller cable slots, lid lip notches for the ADC board
    Base wall top 19.9 -> 22.3 (outer 24.3 with lid), cable slots z 2.4-19.0,
    lid locating lip cut at x +-34 on both long sides for the board's header tabs.
    STEP + STL re-exported; recorded in VERIFIED.md.
2026-10-16 chore: prepare for open source (contributing docs, issue templates, firmware + KiCad CI, BOM buy links)
    - CONTRIBUTING, CODE_OF_CONDUCT, SECURITY; issue forms for bugs, build reports, features
    - CI: compile every UNO Q sketch (arduino:zephyr 1.0.0); KiCad 10 ERC + DRC on the ADC board
    - BOM: Amazon search links (Associates tag) with the required disclosure; ADC board extras
    - README: badges, contributing section; netlist no longer records a local path
2026-10-16 ci: give the KiCad container the default library tables
2026-10-16 docs(bom): link the exact Amazon listings used in the build (#8)
    * docs(bom): link the exact Amazon listings used for load cells, ADC, JST kit and plate
    * docs(bom): link the stripboard listing used in the build
    ---------
2026-10-16 docs(readme): update status for hardware bring-up and the ADC board (#9)
2026-10-16 docs(harness): one stripboard carrier per plate; CS wired by corner (#10)
2026-10-28 docs(harness): DIYLC project for the plate R carrier (#12)
    make_carrier_diylc.py now writes one project per carrier on the same
    board layout:
    - hardware/carrier-stripboard-right.diy (new): R1-R4 with CS <- D7, D8,
    D9, A2, no DRDY, BUS IN from plate L's BUS OUT, BUS OUT left empty.
    - hardware/carrier-stripboard.diy: the bus strips and notes now say
    that BUS OUT goes on to plate R's BUS IN, and list the wires to the Q.
    - docs/harness.md: links both projects and spells out the chain wiring.
2026-10-28 feat(bench): default the bench tools to one plate's carrier (#11)
    The harness is built as one stripboard carrier per plate (docs/harness.md),
    but multi_cell.py and carrier_check.py defaulted to the old toe set
    (L1, L2, R1, R2) and live_multi.py could only show those four cells.
    - multi_cell.parse_channels: L / R (a plate's four), all, or names;
    the default is plate L. carrier_check --units uses it too, and adds the
    plate L BUS OUT -> plate R BUS IN check when both plates are wired.
    - live_multi --channels (default L): draws each plate in use with its
    corners from open_fp.config, the CoP on each plate (toe/heel,
    inner/outer), and the L/R split when both plates are shown.
    - docs/harne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
2026-10-28 feat(bench): app UI on the real plates over a 200 Hz bench stream (#13)
    * feat(bench): app UI on the real plates over a 200 Hz bench stream
    The production firmware and board-side main.py aren't written yet, so the
    app's UI has only run on synthetic swings. This feeds it real plate data:
    - bench/ads1220_stream: reads all 8 ADS1220s on L1's DRDY (~1 kHz),
    averages into 5 ms frames and prints 10 frames per Monitor line
    (B,<seq>,<t_first_us>,<period_us>,<flags>,<hex>), the fields of
    protocol.py's Batch.
    - tools/bench/live_plates.py: parses those lines into Batches and runs
    them through open_fp.app.Core behind the simulator's WebUI stand-in,
    serving app/assets on :7070. Seeds bench/li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
2026-10-28 docs(research): Swing Catalyst features, taught metrics, and what to build (#15)
    Companion to the Smart2Move comparison. Covers Swing Catalyst's products,
    the software features coaches use, how it teaches reading pressure and
    vertical-force data, published reference values, a mapping to open-fp's
    current metrics, a prioritized build list for vertical-force-only plates,
    and what our hardware can't measure.
2026-10-29 feat(metrics): explained metric cards with reference ranges and vertical-force timing (#16)
    Swing metrics are now cards in three sets (Weight shift, Vertical force,
    Timing). Each card has a "?" explanation, a published reference range where
    one exists, and the golfer's own mean ± SD across the library. Force metrics
    can be shown as %BW or newtons.
    analyze() adds the downswing peak of total vertical force and the unweighting
    minimum before it, each timed against transition and impact. Peaks are now
    taken from max trail to finish, so a step off the plates after the finish
    can't count as the peak. The simulator's swing gains an unweighting dip.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
2026-11-11 feat(pcb): ADC board rev B, 204.5 mm long with an OpenFlight logo (#22)
    * feat(pcb): ADC board rev B, 204.5 mm long with an OpenFlight logo
    Same circuit, parts, nets, pin map and per-channel layout as rev A, in a
    board 80 mm shorter (204.5 vs 284 mm). Each end's two channel blocks now
    pack together 5.5-7 mm from the shield headers, the heel pair over the
    header-free end of the Q, and the outer plugs overhang the board ends.
    Cable slots, mounting holes and the enclosure changes they need are in
    the README; the enclosure CAD is not updated yet.
    The OpenFlight logo is on the top silkscreen, generated from
    art/openflight-logo.png by scripts/make_logo.py in 0.16 mm pixels so no
    printed feature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
2026-11-11 feat(cad): centre enclosure rev B for the 204.5 mm ADC board (#23)
    printed feature is un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
